flexiblestoic/EASYBeeMonitor/media/SpecWeightSensors.pdf

Comprehensive error: 0.2%FS

Rated output: 1.0/0.5±0.15mv/v

Non-linearity: 0.2%FS

Hysteresis: 0.2%FS

Repeatability: 0.15%FS

Creep: 0.15%FS/10 Min

Zero balance: ±0.3mv

Input resistance: 1090±10Ω

Output resistance: 1000±10Ω

Insulation resistance: ≥2000MΩ(100VDC)

Excitation voltage: 5~10VDC

Compensated temp: -10~+40ºC

Use temperature: -20~+55ºC

Temp effect on zero: 0.2%FS/10ºC

Temp effect on span: 0.2%FS/10ºC
