flexiblestoic/EASYBeeMonitor/media/EBM_schematics.pdf

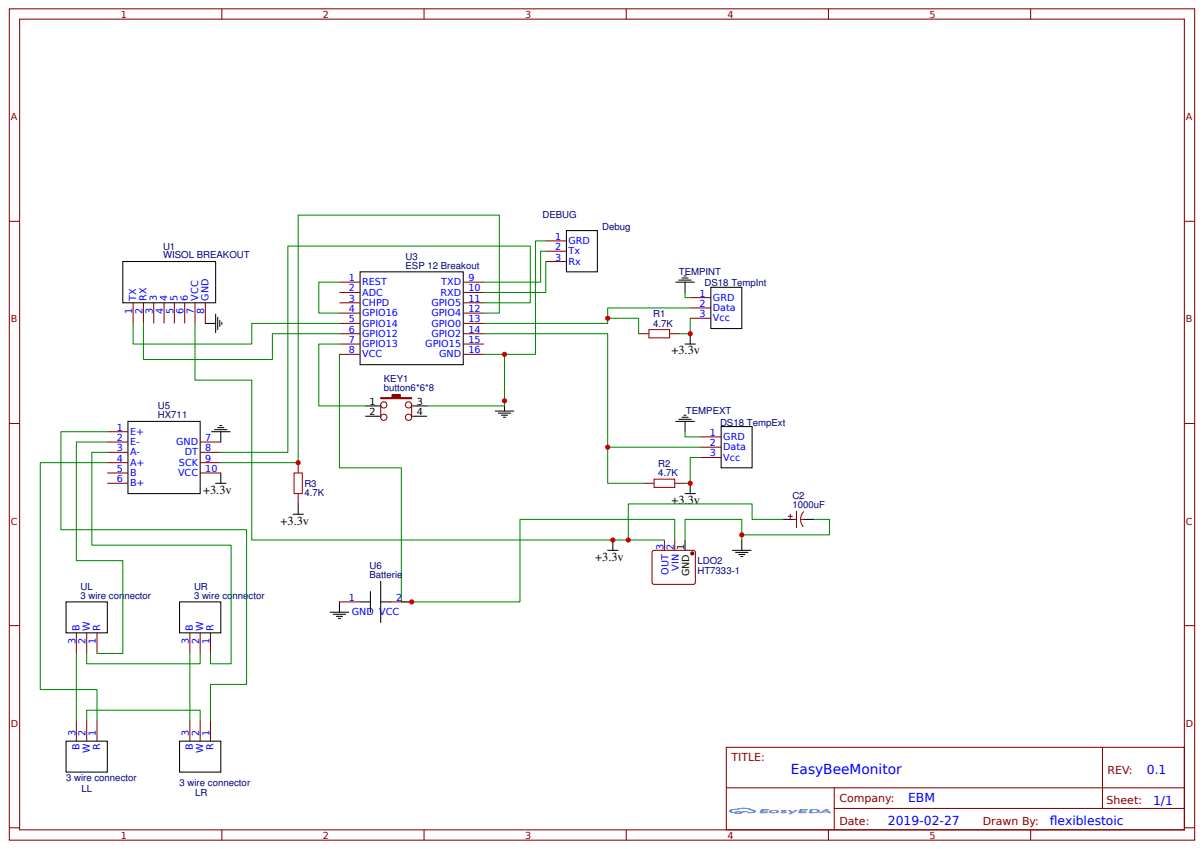
[picture p1: page 1]
